AEFeinstein/swadge-sao/(commit log)

2023-12-23 Added teardrops, signature, C values, oriented labels, cleaned board
    [squarewavebird_sao.kicad_sch]
2023-12-23 Redo board for "Economic PCBA"
    [squarewavebird_sao.kicad_sch]
2024-01-01 Add tooling holes
2024-02-16 Started speaker SAO, added new parts
    [speaker_sao.kicad_pcb, speaker_sao.kicad_sch]
2024-02-16 First pass at speaker schematic
    [speaker_sao.kicad_pcb, speaker_sao.kicad_sch]
2024-02-17 Routed board, added LCSC parts
    [speaker_sao.kicad_pcb, speaker_sao.kicad_sch]
2024-02-17 Added test points, GND vias
    [speaker_sao.kicad_pcb, speaker_sao.kicad_sch]
2024-02-21 Rework speaker SAO with LM4875
    [speaker_sao.kicad_pcb, speaker_sao.kicad_sch]
2024-02-21 Add test points
    [speaker_sao.kicad_pcb, speaker_sao.kicad_sch]
2024-02-22 Add stitched vias, fix DRC warnings
    [speaker_sao.kicad_pcb, speaker_sao.kicad_sch]
2024-02-22 Add more GND vias
    [speaker_sao.kicad_pcb]
2024-02-22 Remove TP from BOM
    [speaker_sao.kicad_sch]
2024-02-24 Rework jack inputs, test points
    [speaker_sao.kicad_pcb, speaker_sao.kicad_sch]
2024-02-25 Added pin numbers, cleanup, DRC rules
    [speaker_sao.kicad_pcb]
2024-02-25 Fixed DRC
    [speaker_sao.kicad_pcb]
2024-02-25 Added LCSC parts, reworked for 1206 cap
    [speaker_sao.kicad_pcb, speaker_sao.kicad_sch]
2024-02-27 Added val to inline jack resistor, fix paste layer
    [speaker_sao.kicad_pcb, speaker_sao.kicad_sch]
2024-02-27 Update to Kicad 8
    [speaker_sao.kicad_pcb, speaker_sao.kicad_sch]
2024-02-27 Add tooling holes, fillet tracks
    [speaker_sao.kicad_pcb, speaker_sao.kicad_sch]
2024-02-27 Add teardrops
    [speaker_sao.kicad_pcb]
2024-02-27 Switched 100uF cap
    [speaker_sao.kicad_pcb, speaker_sao.kicad_sch]
2024-02-28 Switched 100uF cap to tantalum
    [speaker_sao.kicad_pcb, speaker_sao.kicad_sch]
2024-05-01 Add template and template instructions
    [sao_template.kicad_sch]
2024-05-01 Add tooling holes to template
    [sao_template.kicad_sch]
